Bardie4/Dexterous/Assembly manual for finger.pdf

# Assembly manual for finger + gearbox

## Step 0:

Make sure to read chapter 3 of “Dexterous Gripper” and familiarize yourself with the tendon principle.

## Step 1:

Insert 1m of string through the locking hole of the motor spindle, with equal length of string sticking out on both sides.

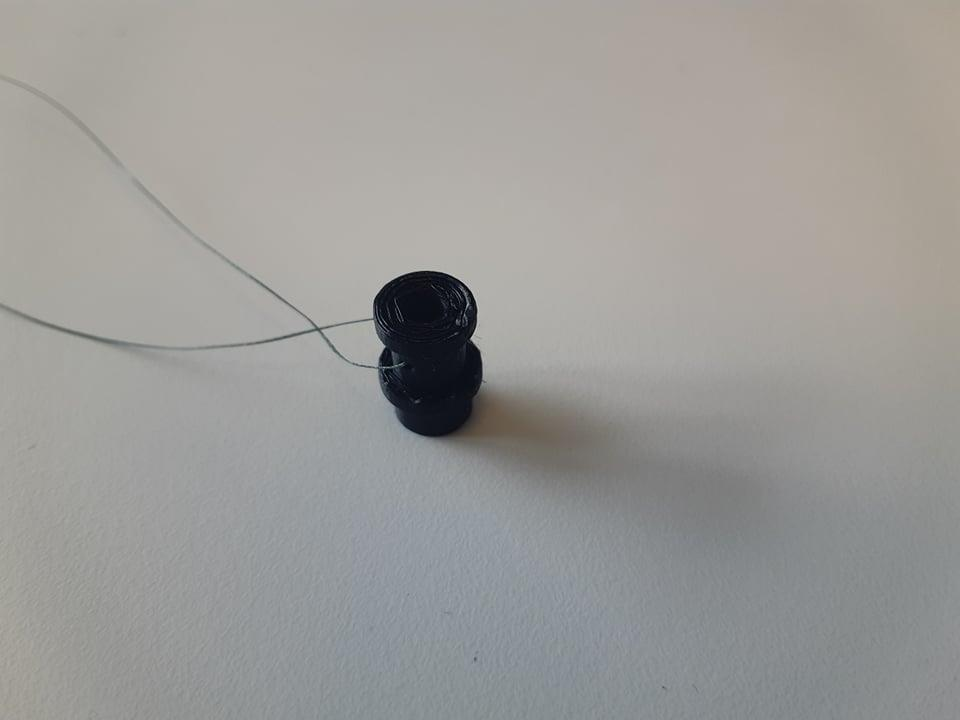
[picture p22: figure]

## Step 2:

Gently push the motorspindle onto the motor. Don’t push it all the way down. It will be pushed in place by the front/back plate later.

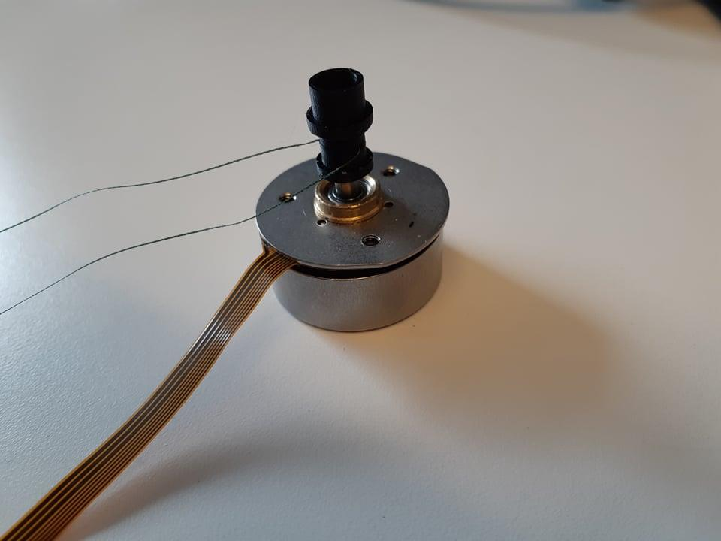
[picture p23: figure]

## Step 3:

Insert 1m of string through the locking hole of the gear spindle. Insert the 30mm M3 bolt through the gear top

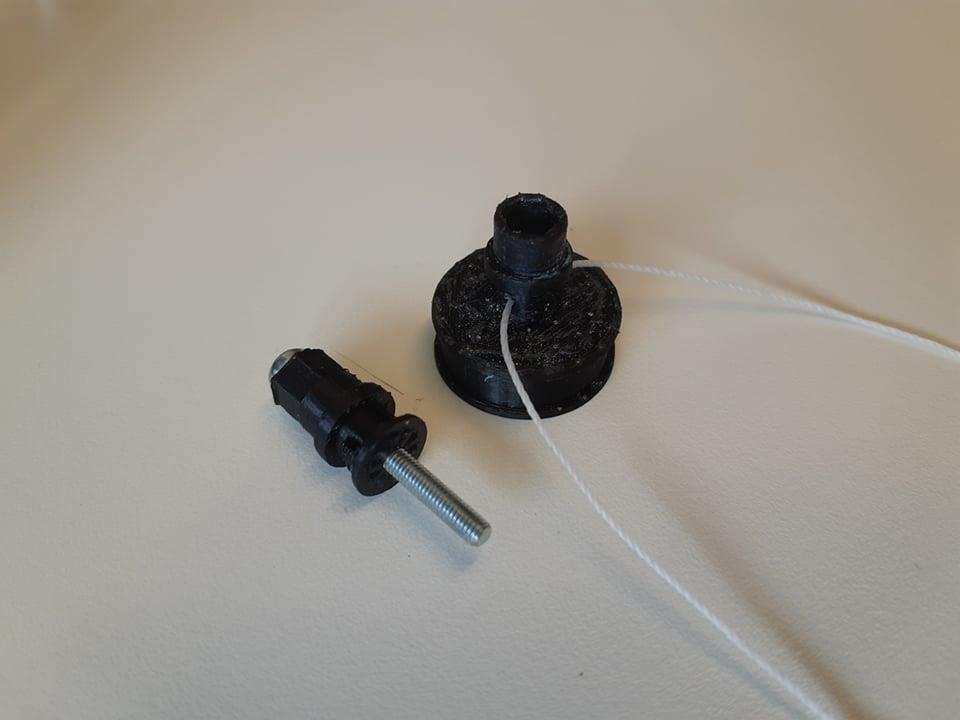
[picture p24: figure]

## Step 4:

Use the bolt to push the string out of the hole in the middle of the gearspindle. The string will later be locked in place when the hex nut is placed at the end of the bolt.

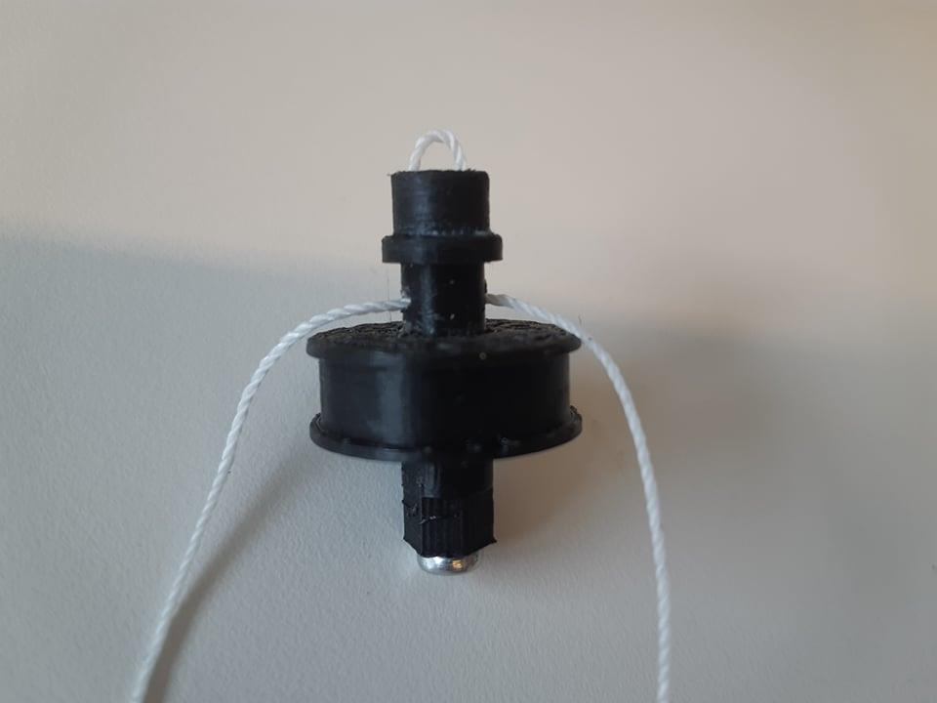
[picture p25: figure]

## Step 5:

Fasten the motor to the motor bracket as seen in the picture

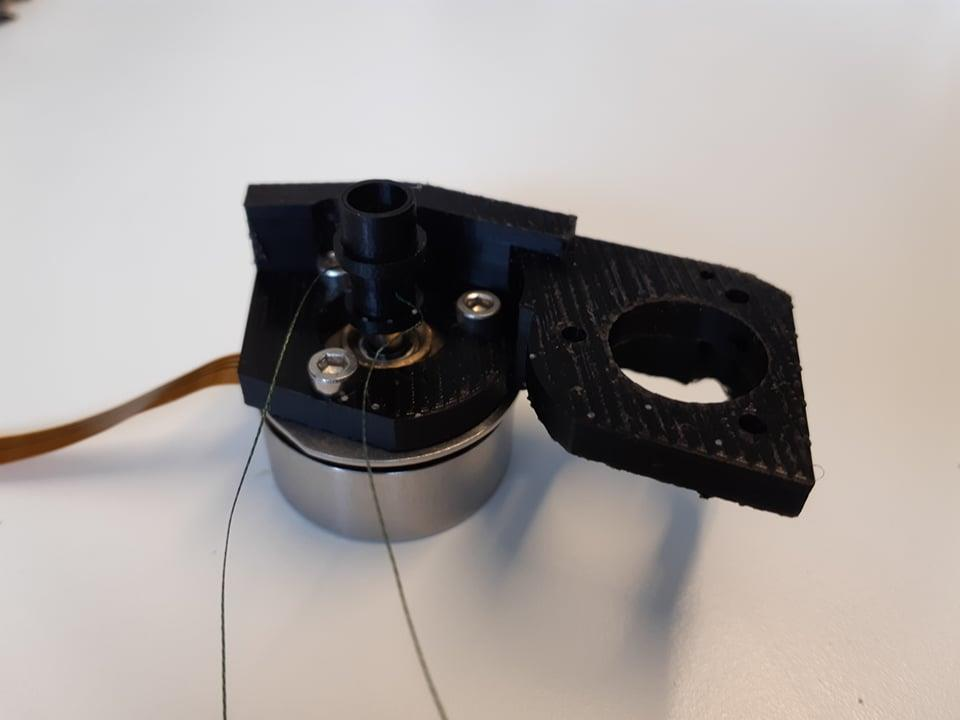
[picture p26: figure]

## Step 6:

Use 10mm M2 bolts to fasten the inner bracket, and the the backplate. Then place the motorspindle in the slot next to the motor. The motorspindle and backplate has a hole which can be used to lock the gearsindle in place and keep it from rotating, which makes the string easier to wind around the motor spindle. To lock the motor in place, use tape.

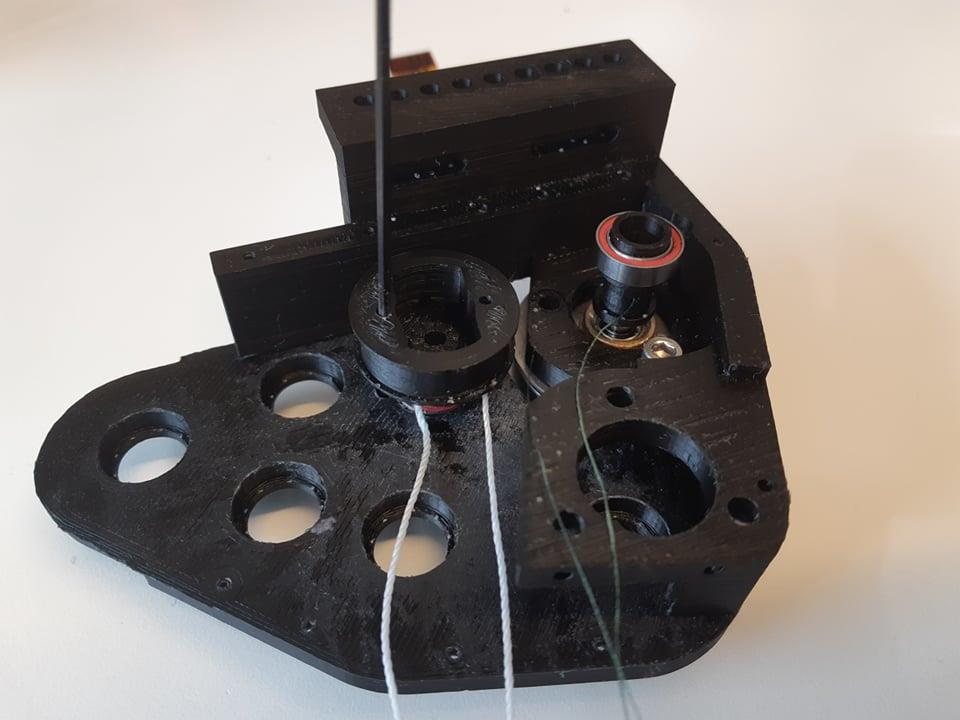
[picture p27: figure]

## Step 7:

Take one side of the string from the motor spindle, and wind it 8 times around the motor spindle downwards in a spiral. Then, without a single turn around the gear spindle, route it directly through the bottom hole on the top pulley, as seen in the picture.

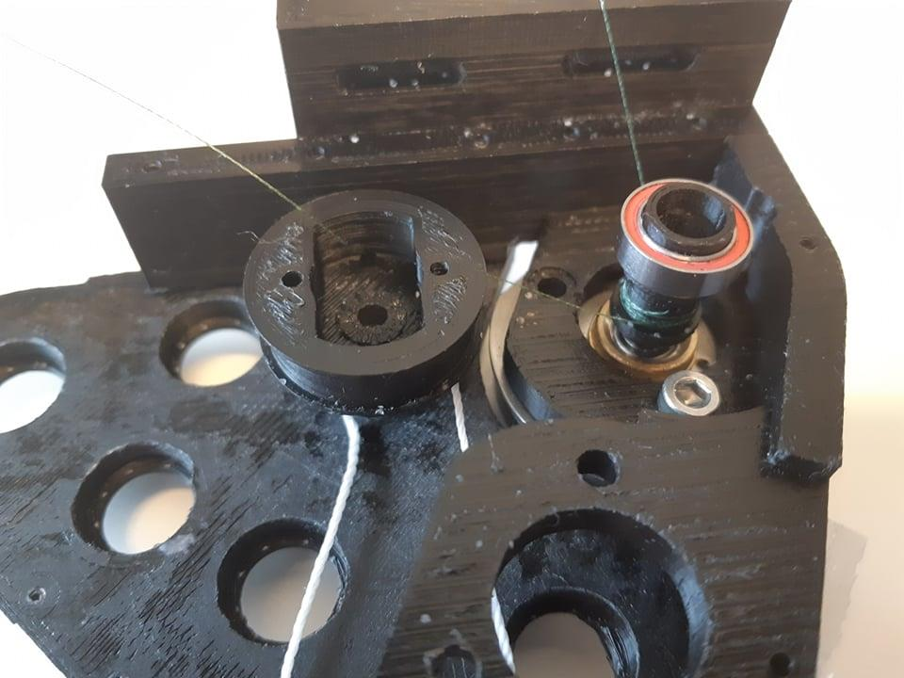
[picture p28: figure]

## Step 8

The other side of the string goes directly from the motor spindle and is wound around the gear spindle until it is of the same length as the string that is already in place

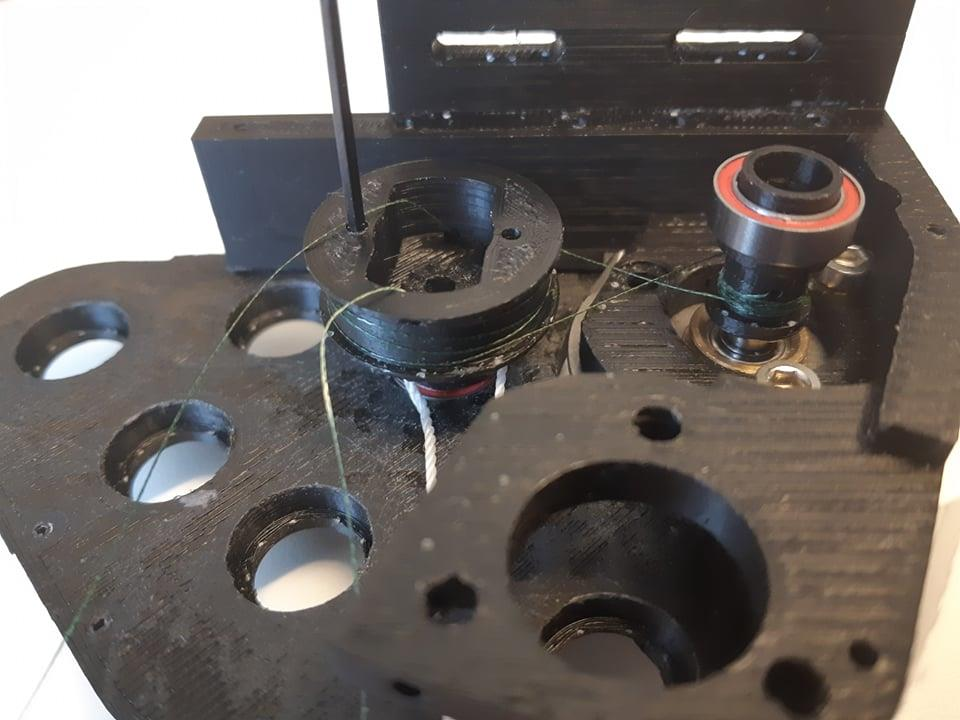
[picture p29: figure]

## Step 9:

The string is then fastened to the gear spindle top. It needs to be connected in a loop so that the tension in both side has a chance to equalize. In the picture below, this is done by using another loop. However, just tying it to itself in a loop is sufficient.

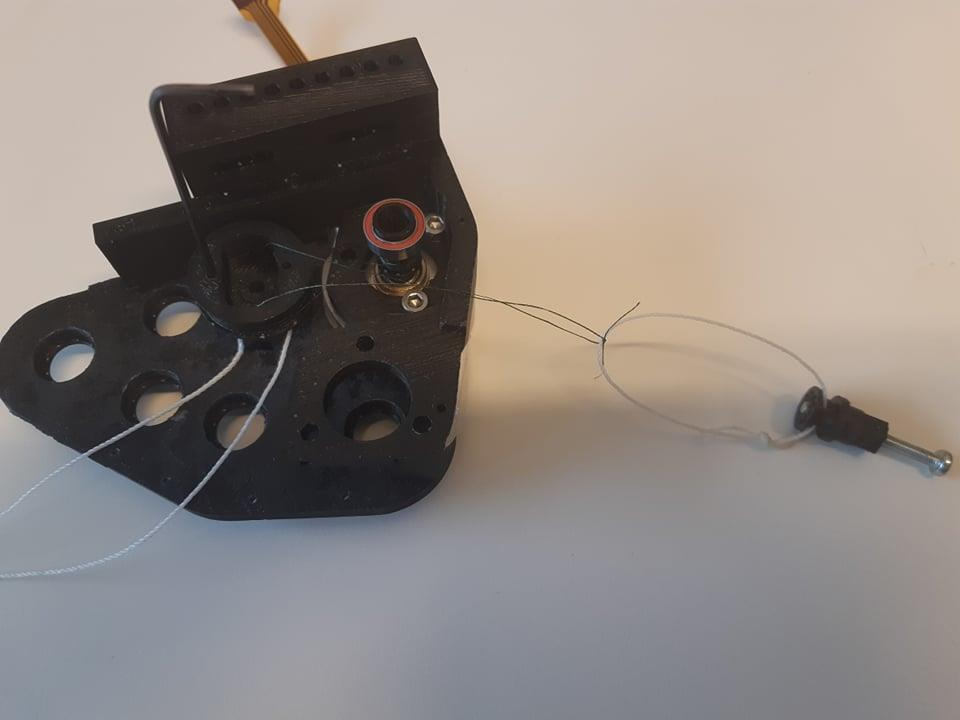
[picture p30: figure]

## Step 10:

The gear spindle top is then wound around to tighten the string and inserted on top of the gear spindle. Make sure the string does not wind around the bolt, as sharp edges will cut the string.

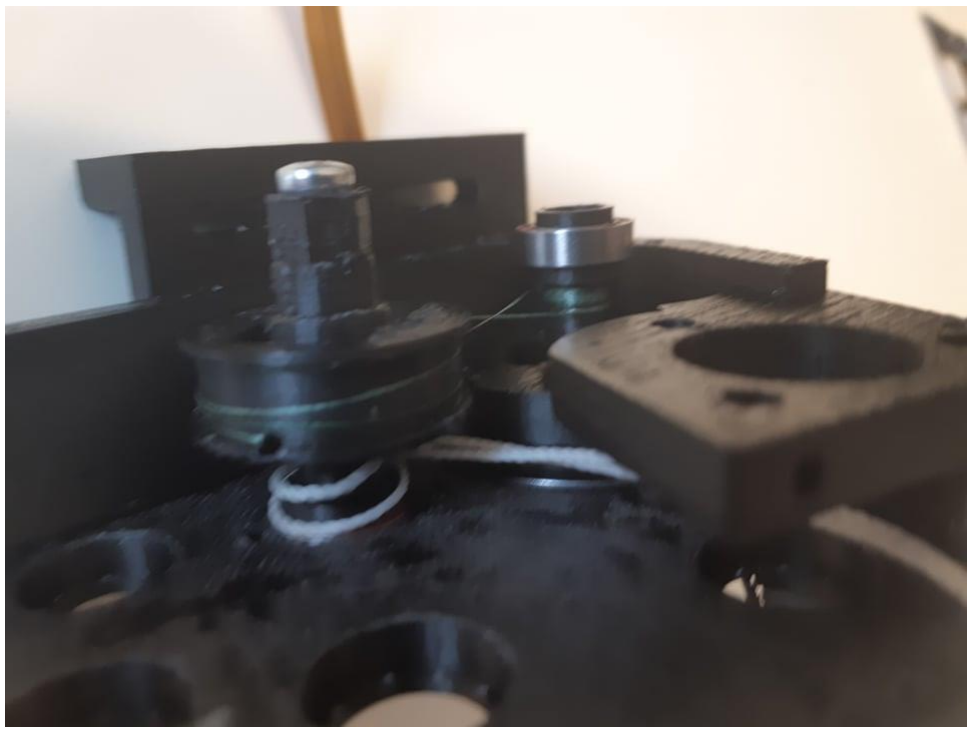
[picture p31: figure]

## Step 11:

The frontplate is attached, and the blackplate is removed, revealing the the gearbox from the oposite side. Here the hex nut which keeps the gear top from unwinding and locks the string on the second stage is revealed.

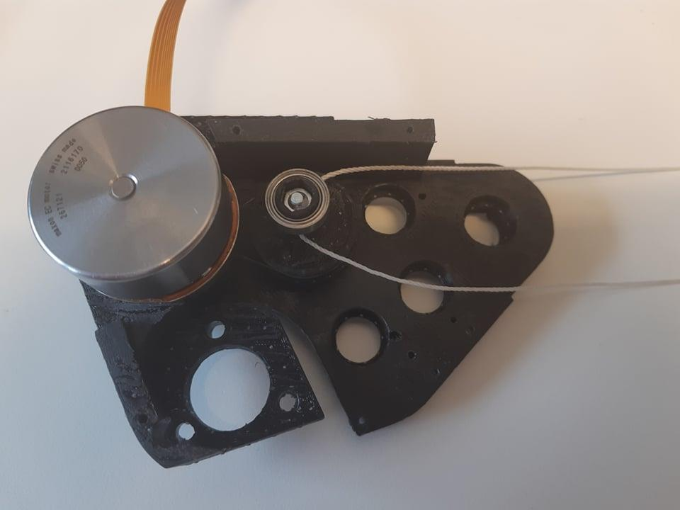
[picture p32: figure]

## Step 12:

The process of readying the gear spindle and motor spindle is repeated, and the motor spindle and gear spindle is mounted on the frontplate as in the picture below.

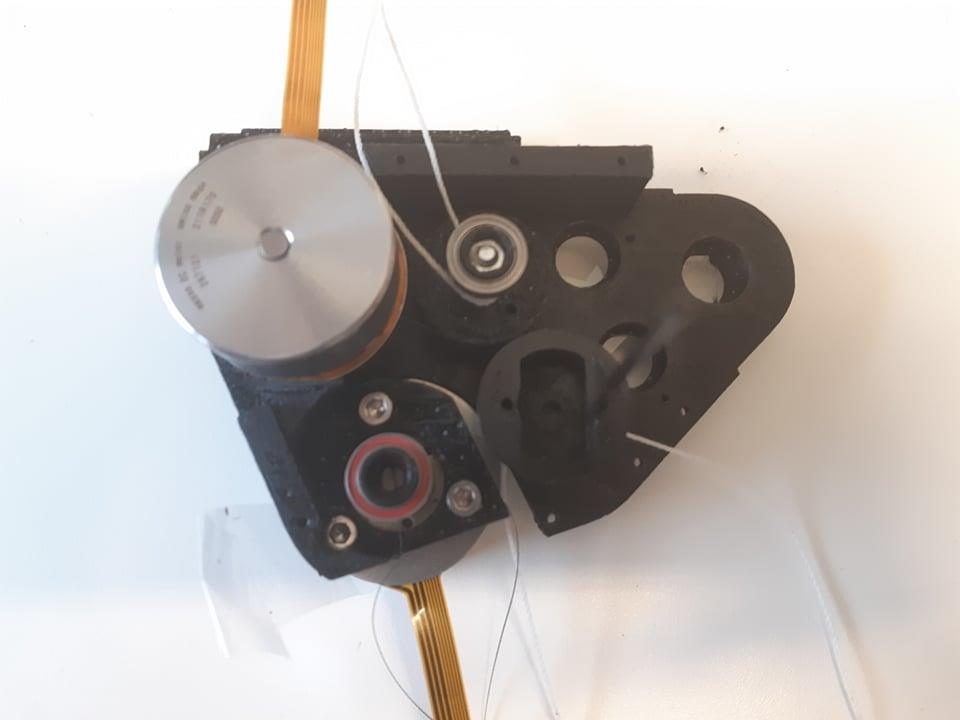
[picture p33: figure]

## Step 13:

In the same way as with the previous motor: One side of the string is wound 8 times around the motor spindle, then it goes directly into the gear spindle without any turns. The other side leaves the motor spindle without any turns, and is then wound around the gear spindle until the string is of equal length.

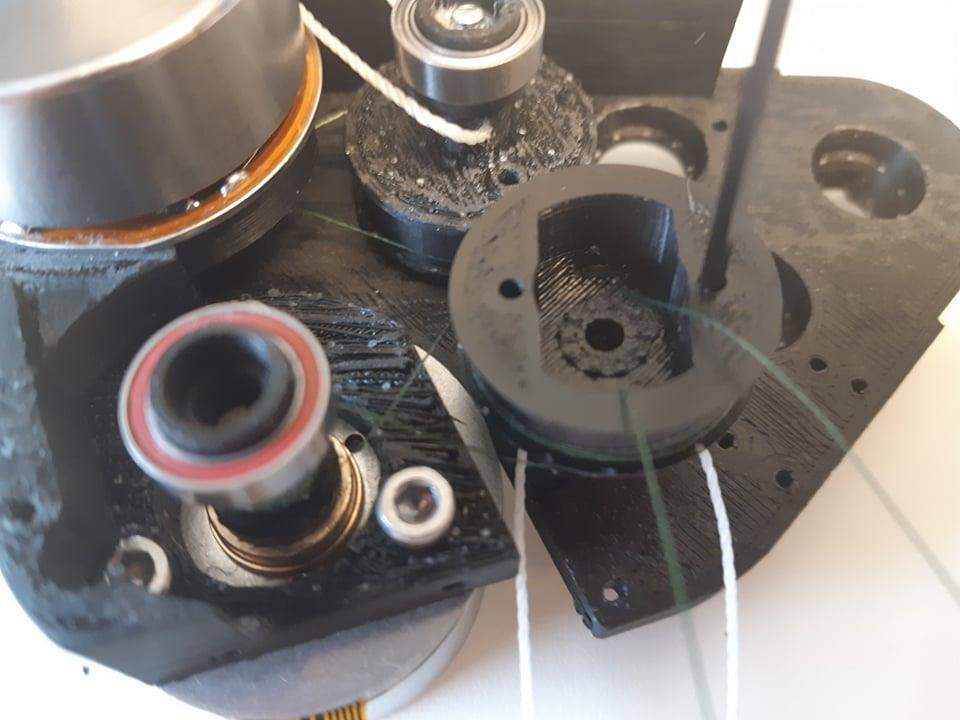
[picture p34: figure]

## Step 14:

Again, the strings are attached to the gear spindle top in a loop.

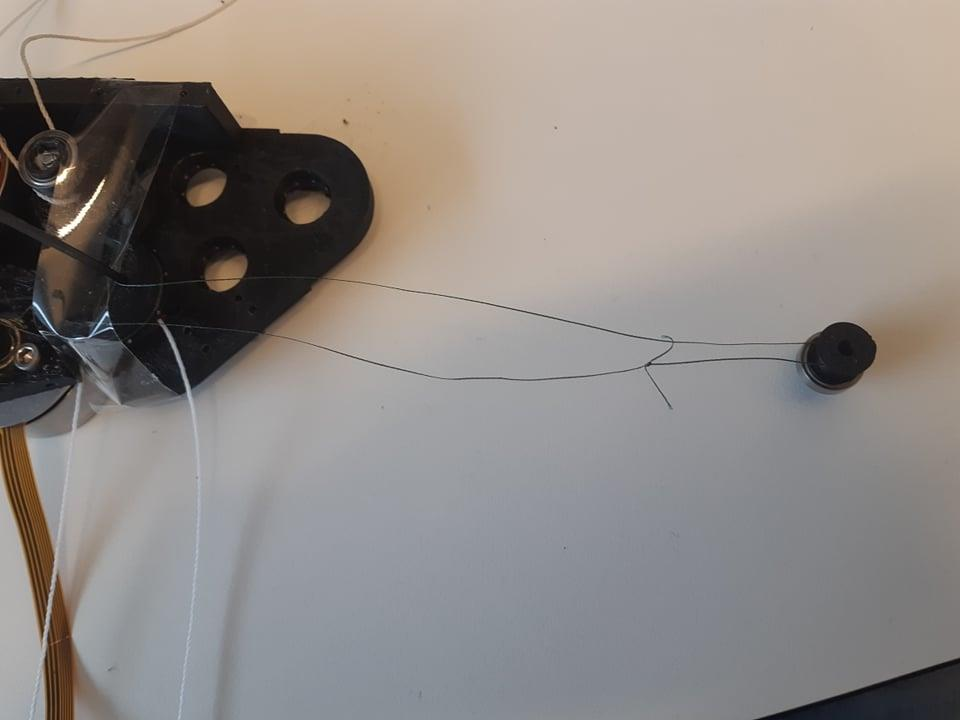
[picture p35: figure]

## Step 15:

Mount the gear top, and tighten the string by twisting it around. Then lock it in place by inserting the hex nut and tightening the bolt.

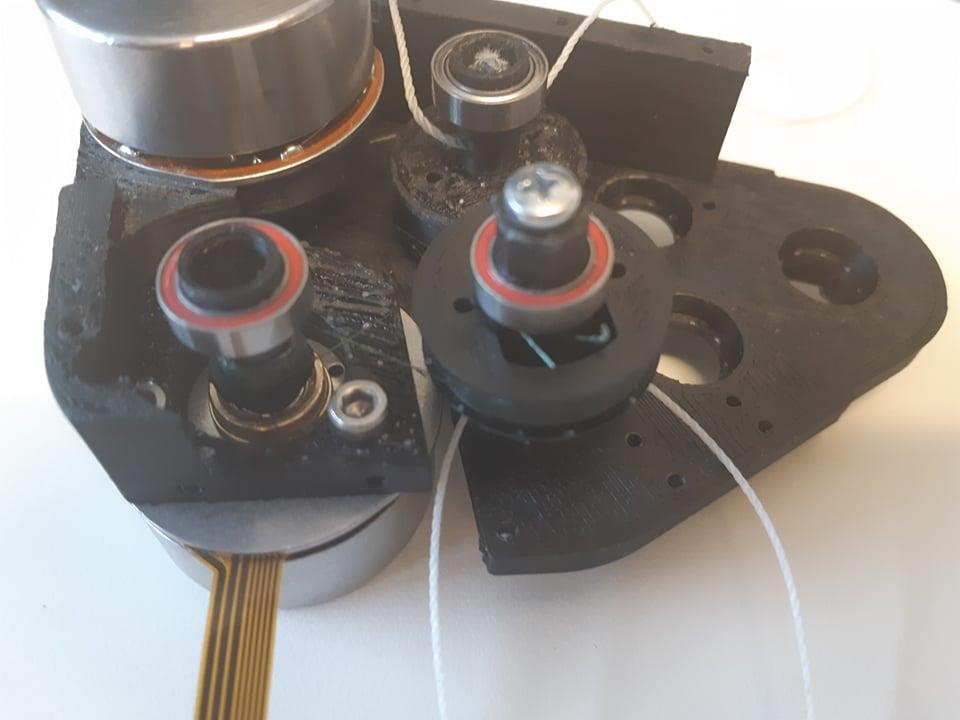
[picture p36: figure]

## Step 16:

With both the backplate and front plate in place; move the motor back and forth and try to make the string between the gear spindle and motor spindly into a nice and tidy spiral. Tighten any slack.

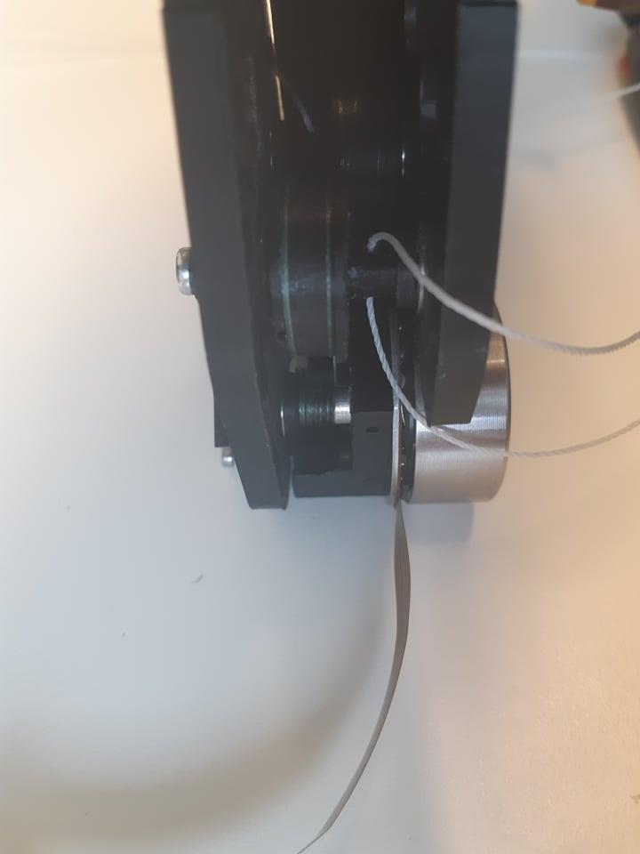
[picture p37: figure]

Step 17:

Insert the finger in place in the gearbox.

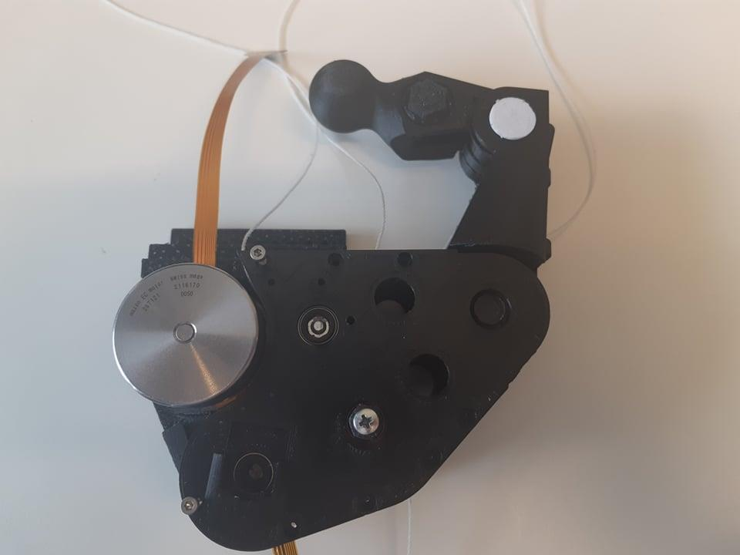
[picture p38: figure]

Step 18:

Turn the motor until it reaches the end position. Take the tendon end that will be tightened by moving it away from the end position and route it into the PIP joint pulley as seen in the picture below.

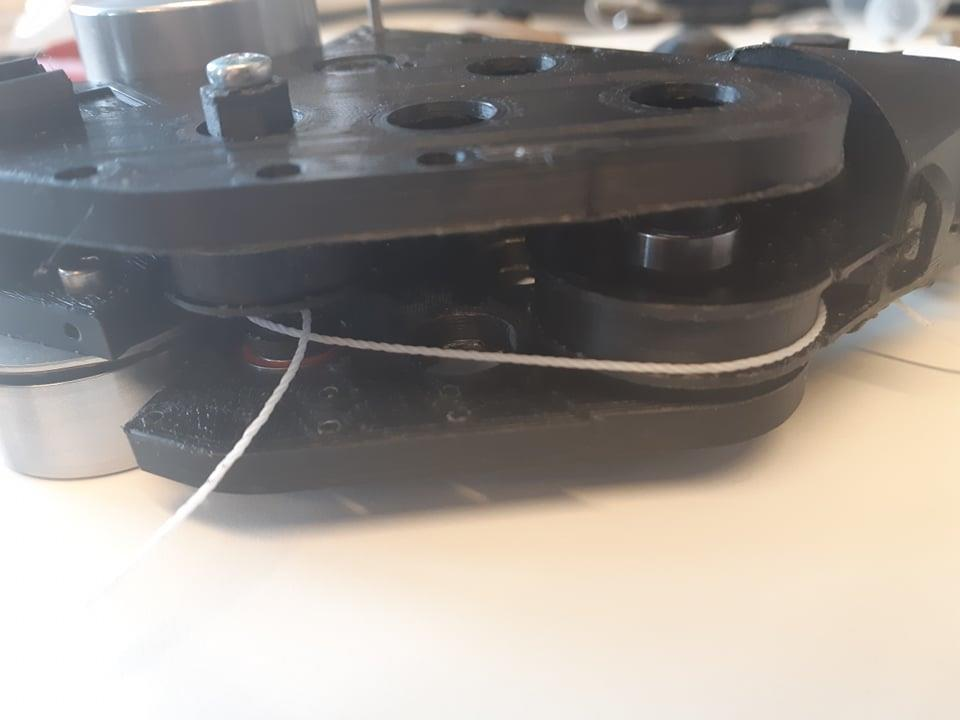
[picture p39: figure]

## Step 19:

In the picture below, the finger has been rotated to reveal the side where the string comes out of when inserted into the pulley. There is a groove which ends in a hole where the string is led to the tightening slots.

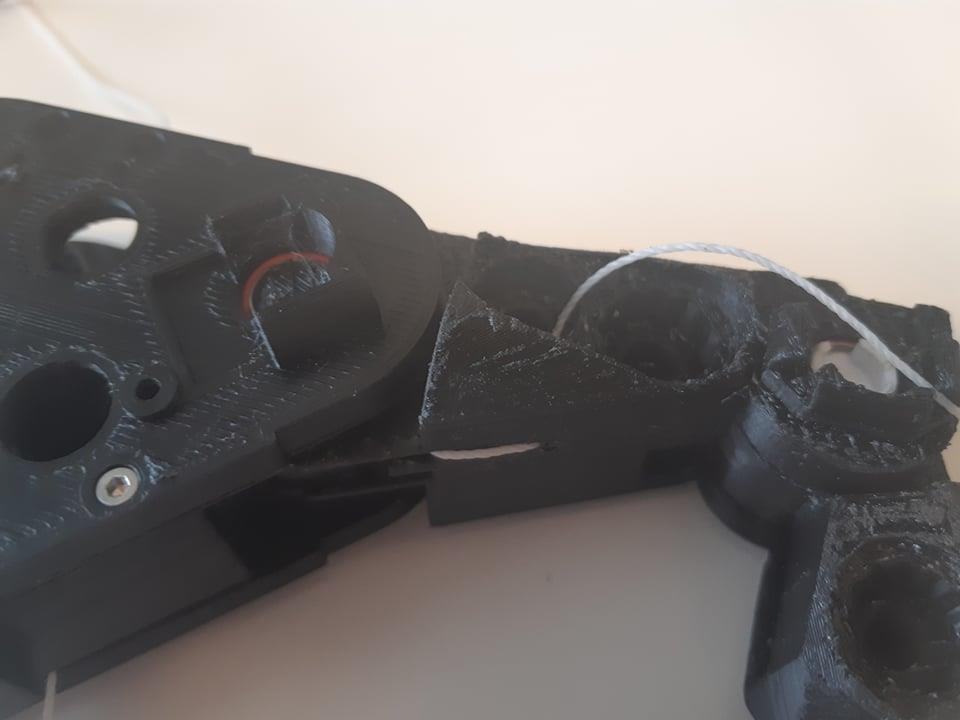
[picture p40: figure]

## Step 20:

Tie the string to the tuning peg

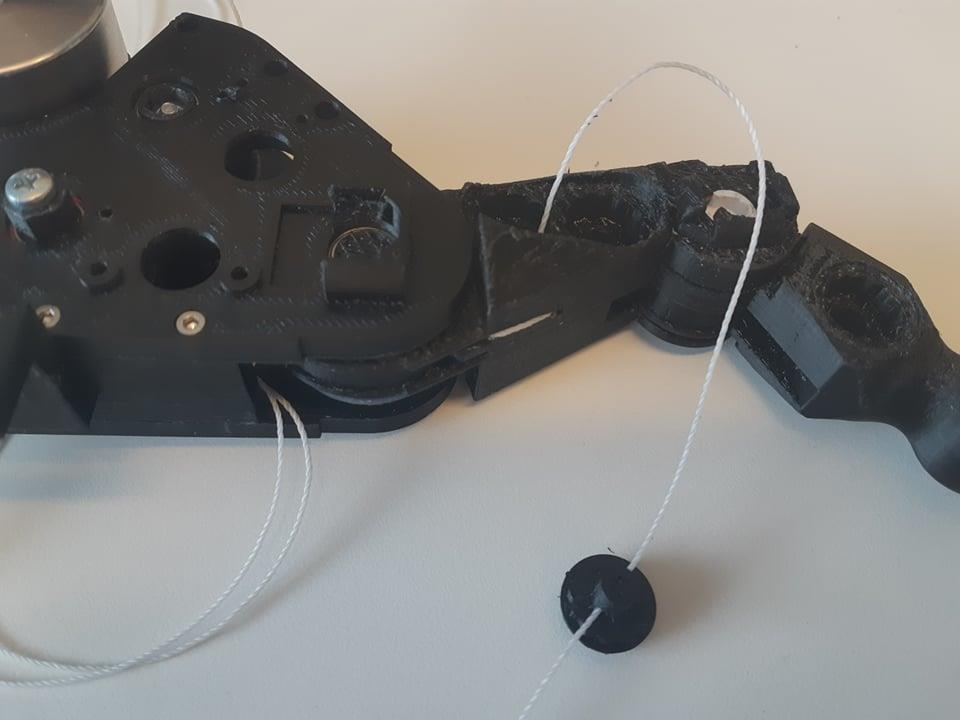
[picture p41: figure]

## Step 21:

Rotate the tuning peg to tighten the string and insert it into the slot.

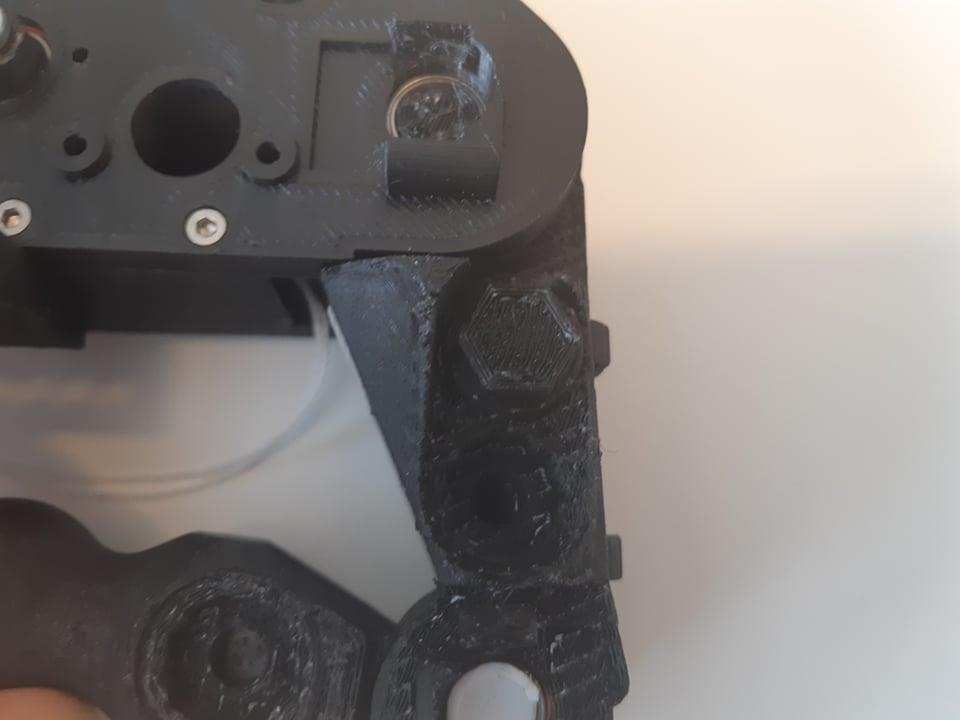
[picture p42: figure]

## Step 22:

Take the other side of the string and rotate it 3 times around the gear spindle before routing it around the other side of the PIP joint.

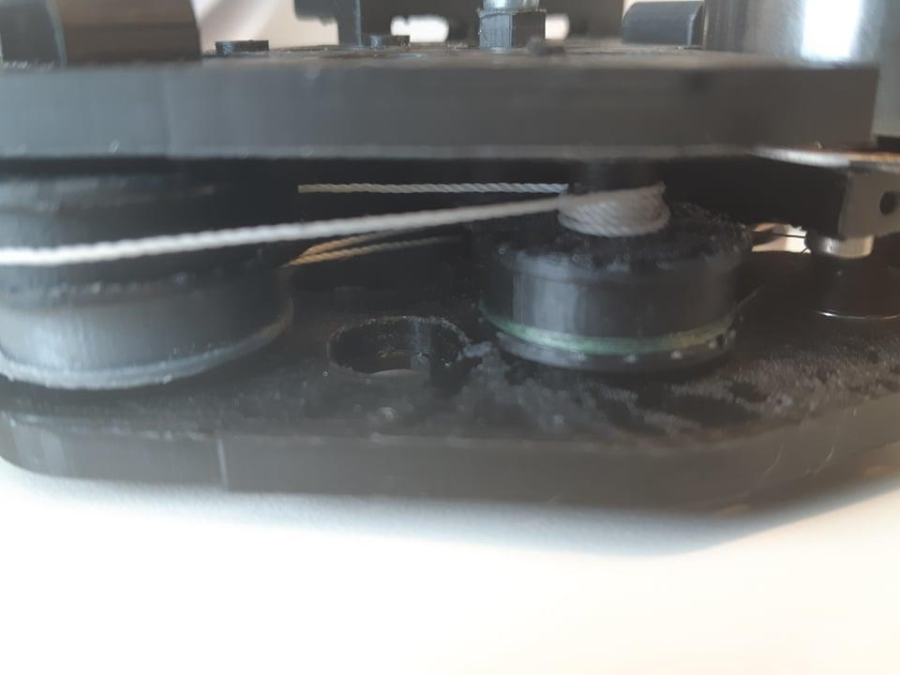
[picture p43: figure]

## Step 23:

On the other side of the pulley, the string goes into a groove which leads to a hole into the tightening slot. Fasten the string to the tuning peg, and tighten the tendon.

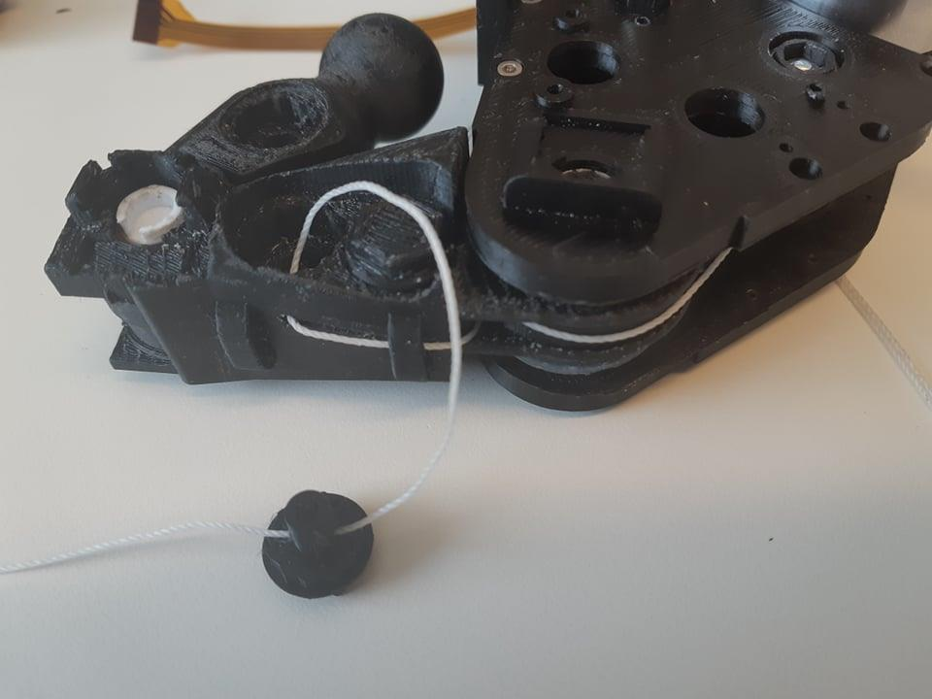
[picture p44: figure]

## Step 24:

Insert the tension pulleys as it is done in the picture below. Then the motor is driven to its end position. The string that is tightened by moving away from the end position is routed as in the picture below. It passes by one tension pulley and then the wheel before it goes into the proximal phalanx to the MCP joint.

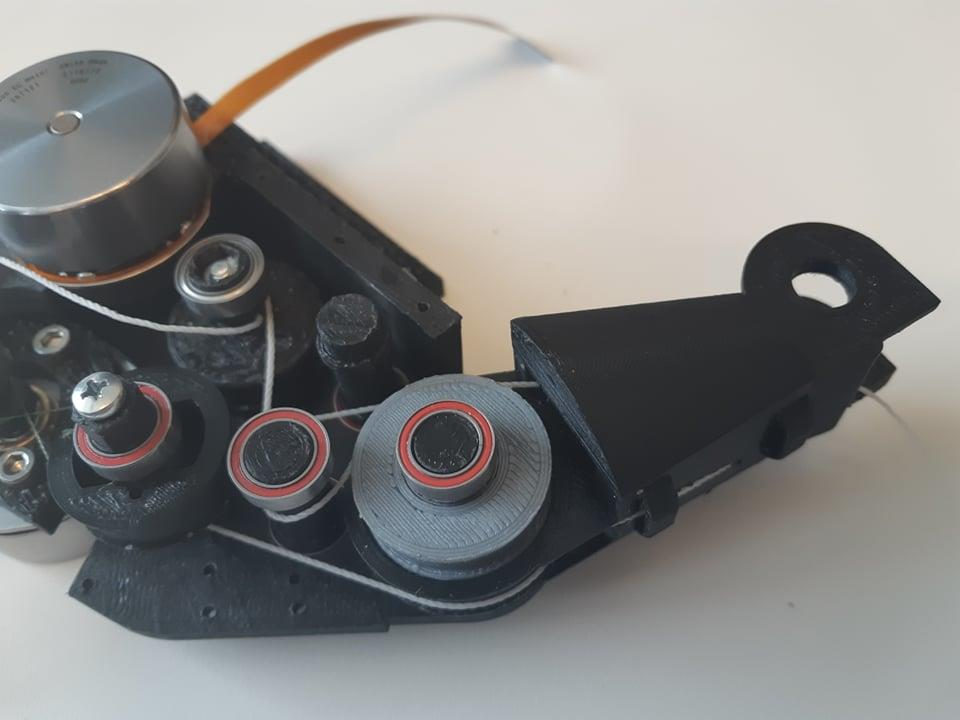
[picture p45: figure]

## Step 25:

The other side is twisted 3 times around the motorspindle before being routed around the other pulley, and wheel before it goes into proximal phalanx.

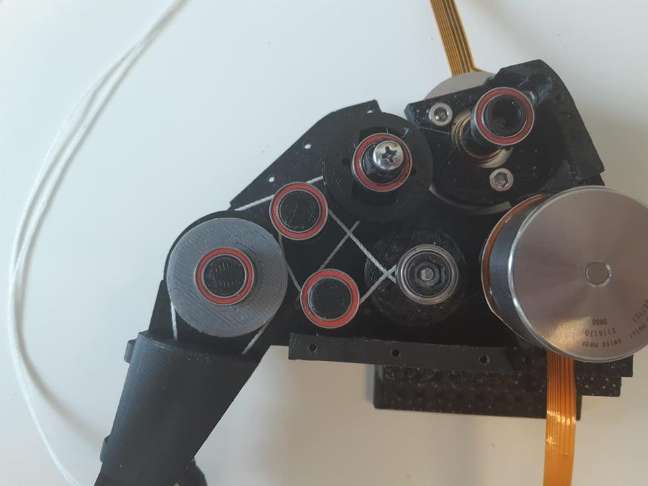
[picture p46: figure]

## Step 26:

From the wheel, to the MCP joint, the tendon is in crossed configuration. Route them around the last pulley and into the tightening slot

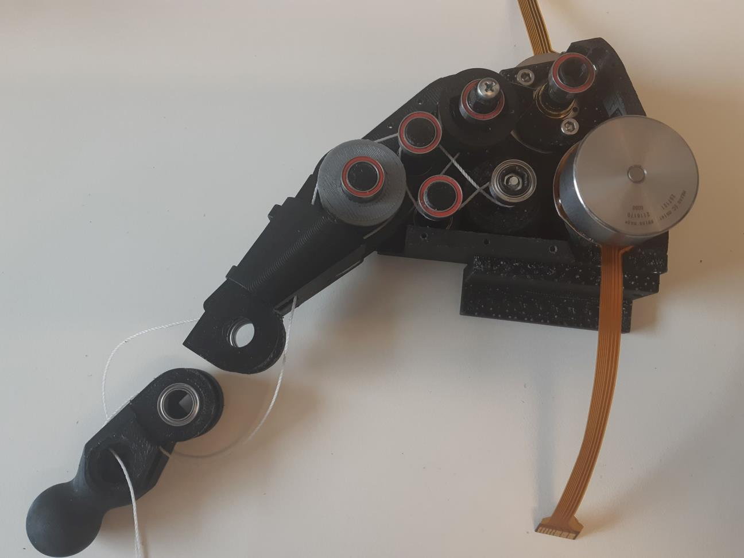
[picture p47: figure]

## Step 27:

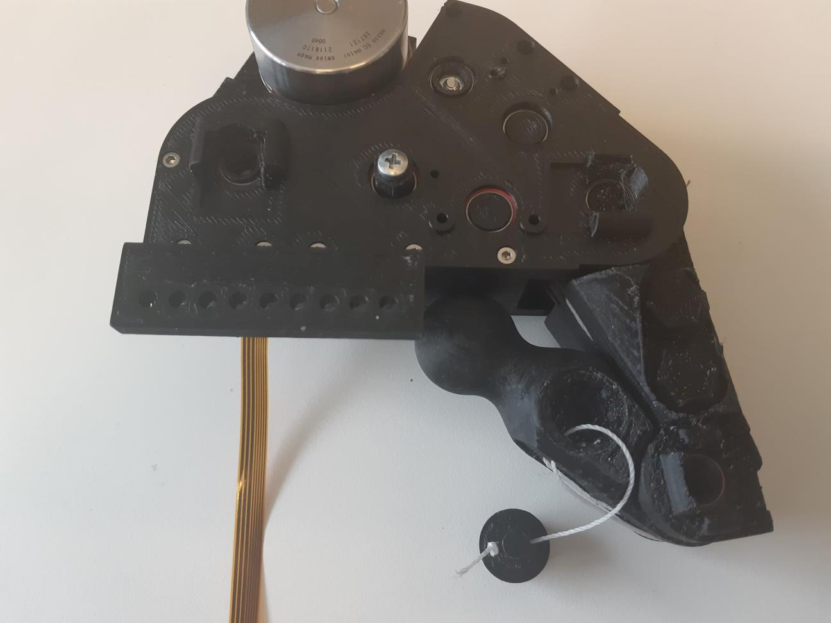
[picture p48: figure]

Fasten the joint and tie the tendon to the tuning peg. Tigheten both sides of the tendon.

## Step 28:

Insert magnets into the cup of the motor spindles, and joints.

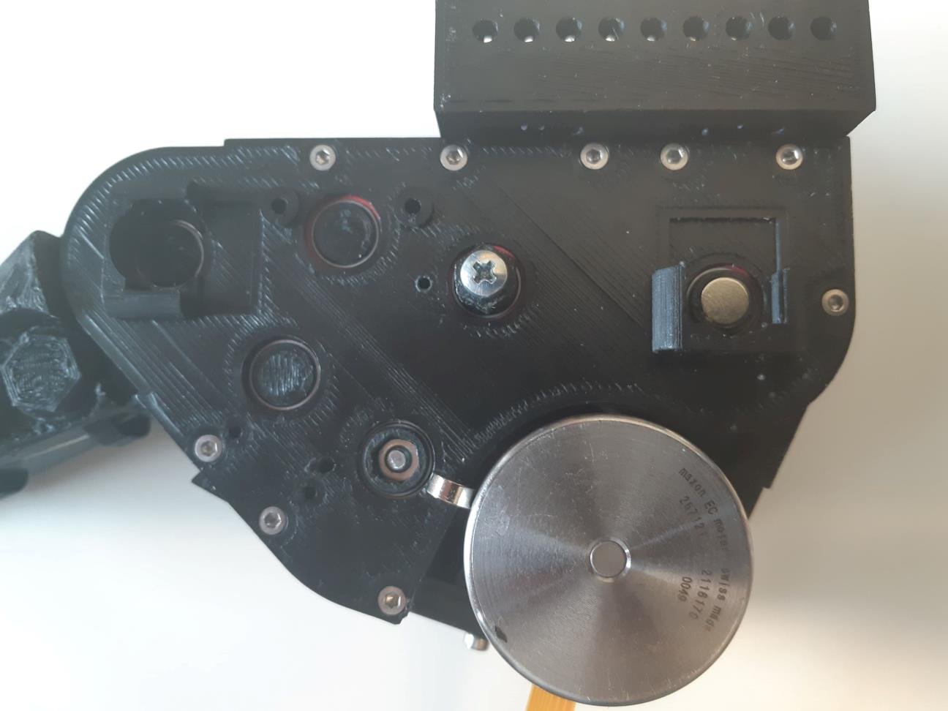
[picture p49: figure]

## Step 29:

Slide sensors into sensor slots and attach the cables. Cable clamps can be mounted anywhere to route the cables as you see fit.

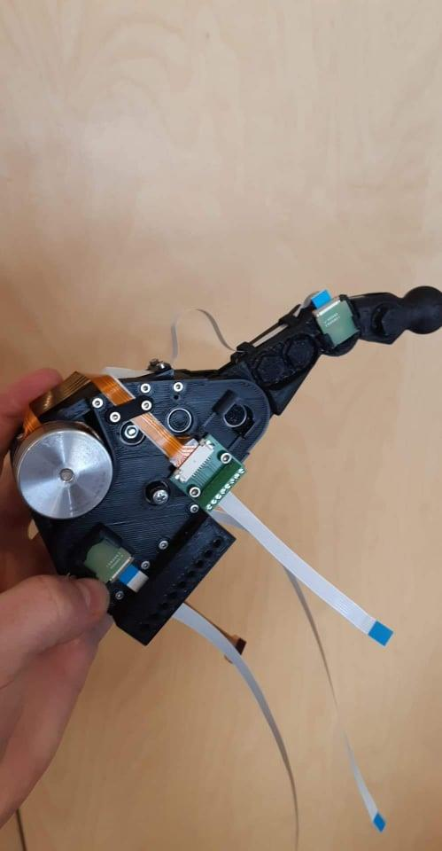
[picture p50: figure]
