Bardie4/Dexterous/Gripper_monitor_rev2/test.csv

83.3263 | 130.642 | 3.34671 | 3.04912 | 0.0149274 | 0.0210869 | 9.53674e-07
83.3044 | 130.642 | -3.02648 | 2.87622 | 0.0148305 | 0.0210869 | 0.00973082
83.2609 | 130.664 | -15.1378 | 12.3249 | 0.0148305 | 0.0210869 | 0.0195189
83.3044 | 130.642 | 2.67072 | 0.371999 | 0.0149274 | 0.0209822 | 0.0326209
83.3263 | 130.62 | -2.72271 | -3.49461 | 0.0147822 | 0.0210869 | 0.0389378
83.3263 | 130.599 | 9.34835 | -8.51152 | 0.0149758 | 0.0210869 | 0.0486939
83.2827 | 130.664 | -8.78771 | 6.73674 | 0.0148305 | 0.0209822 | 0.058475
83.3263 | 130.599 | 7.45486 | -10.2977 | 0.014879 | 0.0209822 | 0.0682678
83.2827 | 130.664 | -6.01881 | 4.56991 | 0.0148305 | 0.0208771 | 0.0780079
83.3263 | 130.642 | 8.54464 | 0.499287 | 0.0149274 | 0.0209822 | 0.0878088
83.3044 | 130.62 | 6.22611 | 1.77796 | 0.0149758 | 0.021192 | 0.0975308
83.3263 | 130.664 | 6.48297 | 13.3455 | 0.0149274 | 0.021192 | 0.107287
83.3263 | 130.599 | 5.12386 | -3.80595 | 0.014879 | 0.0210869 | 0.117324
83.3044 | 130.664 | 7.16378 | 6.88488 | 0.0149758 | 0.0209822 | 0.126747
83.3044 | 130.62 | -2.58275 | -4.68319 | 0.0148305 | 0.0209822 | 0.136492
83.3044 | 130.62 | -2.57415 | -5.39358 | 0.0148305 | 0.0209822 | 0.146314
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
