Bardie4/Dexterous/esp_single/i2c_slave.cpp

#include "i2c_slave.h"


i2c_slave::i2c_slave(uint16_t slave_addr){
  i2c_port_t i2c_slave_port = I2C_EXAMPLE_SLAVE_NUM;
  i2c_config_t conf_slave;
  conf_slave.sda_io_num = I2C_EXAMPLE_SLAVE_SDA_IO;
  conf_slave.sda_pullup_en = GPIO_PULLUP_DISABLE; //ENABLE (PI has pullup)
  conf_slave.scl_io_num = I2C_EXAMPLE_SLAVE_SCL_IO; 
  conf_slave.scl_pullup_en = GPIO_PULLUP_DISABLE;  //ENABLE
  conf_slave.mode = I2C_MODE_SLAVE;
  conf_slave.slave.addr_10bit_en = 0;
  conf_slave.slave.slave_addr = slave_addr;
  i2c_param_config(i2c_slave_port, &conf_slave);
  i2c_driver_install(i2c_slave_port, 
                      conf_slave.mode,
                      I2C_EXAMPLE_SLAVE_RX_BUF_LEN,
                      I2C_EXAMPLE_SLAVE_TX_BUF_LEN, 
                      I2C_NUM_1); //I2C_NUM_0

}

i2c_packet i2c_slave::read(){
  incoming.size = i2c_slave_read_buffer( I2C_NUM_0, incoming.data, RW_TEST_LENGTH, 1000 / portTICK_RATE_MS);
  
  return incoming;
}

void i2c_slave::write(uint8_t* data_o){
  i2c_slave_write_buffer( I2C_NUM_0, data_o, sizeof(data_o), 1000 / portTICK_RATE_MS);
}
