Bardie4/Dexterous/(commit log)

2019-02-28 magnet m esp in progress
2019-03-04 Added a raspberrypi folder
2019-03-04 hello world added to RaspberryPi
2019-03-05 SPI test1. Added makefile
2019-03-06 Attempting dasiy chaining SPI sensors
2019-03-08 Attempting bit bang SPI
2019-03-08 Added torque regulator from arduino
2019-03-08 esp_magspwm work, shaky finger
2019-03-11 Using new library for spi
2019-03-11 using new spi library
2019-03-11 Building PID. testscript
2019-03-12 Setting correct command and registry for zero setting
    [main.cpp]
2019-03-12 Added SPI output and diognostic text to console
2019-03-13 Final SPI test
2019-03-18 working pwm
2019-03-19 zmq simple program raspberry
2019-03-21 Arduino update
    [gripper_server.obj]
2019-03-25 testing threading
2019-03-25 Adding zmq code with threading to main raspberry pi scipt
2019-03-25 Added framework for cartesian controller
2019-03-27 Added support for multiple fungers running on separate threads
2019-03-28 Added SPI again
2019-04-04 porting to cpp. Adding separate SPI thread
2019-04-10 two beautiful working motors
2019-04-10 pid scrollthrough working
2019-04-30 i2c esp
2019-04-30 I2C trenger gnd, DUH!
2019-05-14 working i2c
2019-05-15 i2c lib
2019-05-15 i2c loop closed
2019-05-28 gripper monitor 2
2019-05-31 annen spi modus
    [data.csv, manuell_bevegelse.csv, manuell_bevegelse_kort.csv, manuell_bevegelse_mellom.csv, sprang.csv, sprang_0_25_65_25_slack_ff.csv, sprang_65_25_0_25_slack_ff.csv, sprang_65_25_0_25_slack_ff_nymagnet.csv]
2019-05-31 test m spi
2019-06-01 pushing those sweet sweet csv files that i wanted to keep for my self
    [disturbance.csv, disturbance2.csv, ff_slope.csv, radial_20_60.csv, radius_change_60_100.csv]
2019-06-03 Add files via upload
    Assembly manual for finger with gearbox
